RTimothyEdwards/gf180mcu_ocd_sram_test/doc/gf180mcu_ocd_sram_test.png

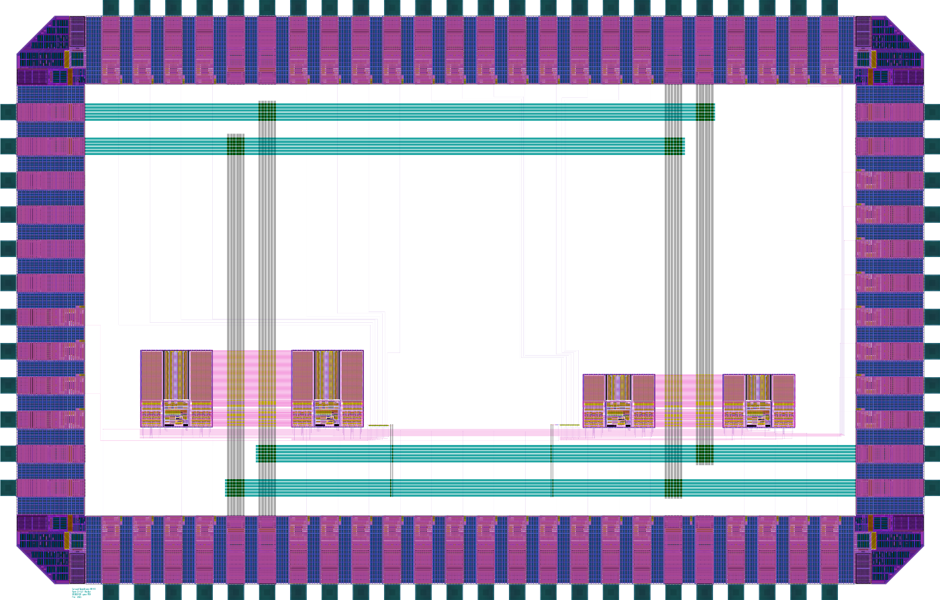
doc/gf180mcu_ocd_sram_test.png
