RTimothyEdwards/gf180mcu_ocd_sram_test/doc/chip_photo.jpg

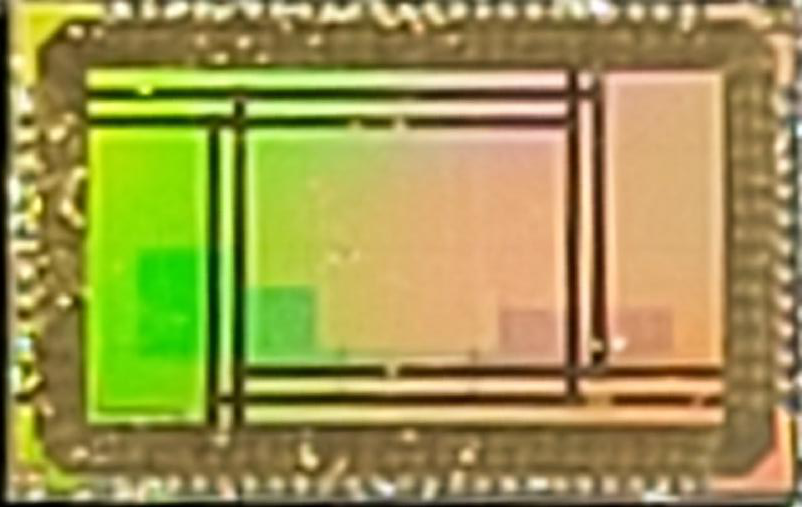
doc/chip_photo.jpg
