RTimothyEdwards/gf180mcu_ocd_sram_test/doc/README

3.3V SRAM and I/O test chip
------------------------
This chip uses a standard wafer.spice 1/2 size frame.
However, to test the 3.3V libraries, the following
changes are made:

(1) Pads are changed to the equivalent ocd_io pad library
    cells, except that the 24um drive pads are replaced
    with standard selectable drive pads.

(2) Every other pair of DVDD/DVSS pads are replaced with
    VDD/VSS pads (3.3V).

(3) The analog pads are not used

(4) The padframe uses a local loopback scheme to provide
    a fixed programming to each bidirectional pad to make
    it either input or output.

(5) Pad assignments are as follows, starting at the lower
    left hand corner and working counter-clockwise:

    Bottom row:
     1 (input only) CLK
     2 (input only) rst_n	(PoR enable)
     3 GWEN
     4 POR output (porb---low during reset)
     5 VSS
     6 VDD
     7 A7	(except for 64 byte SRAM)
     8 A6	(except for 64 byte SRAM)
     9 A5
    10 A4
    11 A3
    12 A2
    13 A1
    14 A0
    15 D7
    16 D6
    17 D5
    18 D4
    19 DVSS
    20 DVDD
    21 D3
    22 D2
    23 D1
    24 D0

   Right side
    25 VSS
    26 VDD
    27 CEN (1024 byte SRAM)
    28 CEN (512 byte SRAM)
    29 CEN (256 byte SRAM)
    30 CEN (64 byte SRAM)
    31 WEN7
    32 WEN6
    33 WEN5
    34 WEN4
    35 DVSS
    36 DVDD

   Top side
    37 WEN3
    38 WEN2
    39 WEN1
    40 WEN0
    41 VDD
    42 VSS
    43 Q7 (1024/512 byte)
    44 Q6 (1024/512 byte)
    45 Q5 (1024/512 byte)
    46 Q4 (1024/512 byte)
    47 Q3 (1024/512 byte)
    48 Q2 (1024/512 byte)
    49 Q1 (1024/512 byte)
    50 Q0 (1024/512 byte)
    51 Q7 (256/64 byte)
    52 Q6 (256/64 byte)
    53 Q5 (256/64 byte)
    54 Q4 (256/64 byte)
    55 DVDD
    56 DVSS
    57 Q3 (256/64 byte)
    58 Q2 (256/64 byte)
    59 Q1 (256/64 byte)
    60 Q0 (256/64 byte)

   Left side
    61 VDD
    62 VSS
    63 (analog, unused)
    64 (analog, unused)
    65 (analog, unused)
    66 (analog, unused)
    67 (input only) output select:  1024 byte or 512 byte
    68 (input only) A9 (1024 byte SRAM only)
    69 (input only) output select:  256 byte or 64 byte
    70 (input only) A8 (512 and 1024 byte SRAMs only)
    71 DVDD
    72 DVSS

----------------------------------------------------
Build procedure:
----------------------------------------------------

    cd magic
    ../scripts/run_gen_gds.sh
    ../scripts/run_fill_gds.sh

Copy the hash results from the last of the scripts into doc/hashes.txt

Run LVS and DRC:

    cd validate
    ./run_lvs.sh
    ./run_drc.sh

Run the complete precheck.  The precheck repository can be cloned and
is https://github.com/wafer-space/gf180mcu-precheck

    1. Start a nix-shell with the "shell.nix" file in the repository above.
	e.g.,

	cd ~/gits/gf180mcu-precheck
	nix-shell shell.nix

    2. Run the command:

	python3 precheck.py \
		--input ~/gits/gf180mcu_ocd_sram_test/gf180mcu_ocd_sram2_filled.gds.gz \
		--top gf180mcu_ocd_sram2_top \
		--slot 1x0p5 --cob \
		--workers max --threads 1

Push back to the repository once validated.

-----------------------------------------------------------------
Wafer.Space COB:

Using the breakout board found at:  https://codeberg.org/rebelmike/ws-breakout

This breakout board routes the 70-pin mezzanine connector to two 0.1" row
headers with 35 positions per row.

Mezzanine connector pin assignments

---------------------------------------------------------------------------------
test    pad	pad	     mezz.	mezz.	pad		pad	test
pin	num	name	      pin	pin	name		num	pin
---------------------------------------------------------------------------------
A3	11	bidir_6		70	1	bidir_5		10	A4
A2	12	bidir_7		69	2	bidir_4		9	A5
A1	13	bidir_8		68	3	bidir_3		8	A6
A0	14	bidir_9		67	4	bidir_2		7	A7
D7	15	bidir_10	66	5	bidir_1		4	POR out
D6	16	bidir_11	65	6	bidir_0		3	GWEN
D5	17	bidir_12	64	7	rst_n		2	rst_n
D4	18	bidir_13	63	8	clk		1	CLK
5.0V	20	VDD_IO_0	62	9	VDD_IO_3	71	5.0V
GND	  	GND		61	10	GND		  	GND
D3	21	bidir_14	60	11	VDD_CORE_1	6 	3.3V 
D2	22	bidir_15	59	12	in_3		70	A8
D1	23	bidir_16	58	13	in_2		69	SEL2
D0	24	bidir_17	57	14	in_1		68	A9
CEN1/5	27	bidir_18	56	15	in_0		67	SEL5
CEN2/5	28	bidir_19	55	16	an_3		66
3.3V	26  	PWR_AUX_0	54	17	an_2		65
GND	  	GND		53	18	GND		  	GND
CEN1/2	29	bidir_20	52	19	PWR_AUX_1	61	3.3V
CEN2/2	30	bidir_21	51	20	an_1		64
WEN0	31	bidir_22	50	21	an_0		63
WEN1	32	bidir_23	49	22	bidir_45	60	Q0/2
WEN2	33	bidir_24	48	23	bidir_44	59	Q1/2
WEN3	34	bidir_25	47	24	VDD_IO_2	55	5.0V  
3.3V	41  	VDD_CORE_0	46	25	GND		  	GND
GND	  	GND		45	26	bidir_43	58	Q2/2
5.0V	36  	VDD_IO_1	44	27	bidir_42	57	Q3/2
WEN4	37	bidir_26	43	28	bidir_41	54	Q4/2
WEN5	38	bidir_27	42	29	bidir_40	53	Q5/2
WEN6	39	bidir_28	41	30	bidir_39	52	Q6/2
WEN7	40	bidir_29	40	31	bidir_38	51	Q7/2
Q7/5	43	bidir_30	39	32	bidir_37	50	Q0/5
Q6/5	44	bidir_31	38	33	bidir_36	49	Q1/5
Q5/5	45	bidir_32	37	34	bidir_35	48	Q2/5
Q4/5	46	bidir_33	36	35	bidir_34	47	Q3/5

Test results below are for the original test chip manufactured on the first
Wafer.Space shuttle run, but the test setup below should be valid for both
versions of the SRAM test chip.

-----------------------------------------------------------------------------
Test with single Digilent Analog Discovery 2:
Exercise Lowest four data bits on D and Q, and lowest six address bits.
Start with the 256 byte side.

Assignments:
Digilent signal board pin
-------------------------
DIO 0	 clk	 8

DIO 1	 gwen	 6

DIO 2	 A0	67
DIO 3	 A1	68
DIO 4	 A2	69
DIO 5	 A3	70
DIO 6	 A4	 1
DIO 7	 A5	 2

DIO 8	 Q3/2	27
DIO 9	 Q2/2	26
DIO 10	 Q1/2	23
DIO 11	 Q0/2	22

DIO 12	 D3	60
DIO 13	 D2	59
DIO 14	 D1	58
DIO 15	 D0	57

All Q pins are for the 256 byte macros.
Data and address pins are shared by both sides.

Constant values:
GND	 D4	63
GND	 D5	64
GND	 D6	65
GND	 D7	66

GND	 A6	 3
GND	 A7	 4
GND	 A8	12
GND	 A9	14

GND	 WEN7	40
GND	 WEN6	41
GND	 WEN5	42
GND	 WEN4	43
GND	 WEN3	47
GND	 WEN2	48
GND	 WEN1	49
GND	 WEN0	50

open	 Q4/2	28
open	 Q5/2	29
open	 Q6/2	30
open	 Q7/2	31

GND	 SEL2	13	(select 256 byte bank 1 or 2 on Q/2 outputs)
GND	 SEL5	15	(select 512 or 1024 byte bank on Q/5 outputs))

GND	 CEN1/5	56	(enable all four for starters)
GND	 CEN2/5	55
GND	 CEN1/2	52
GND	 CEN2/2 51

Because the Digilent DIO channels only go to 3.3V, use 3.3V on the
periphery as well as the core (can also test the core at 1.8V).

Local WEN bits are set to zero;  GWEN controls the read/write state.

SEL lines:  GND selects bank 1, VDD selects bank 2

Functional note:  CEN must be high on power-on and then set to zero for
first use.

Writes must be done by setting GWEN low and applying a pulse on CLK, then
returning GWEN high.  The written value is not immediately available at
the output;  reading the output requires an additional pulse on CLK with
GWEN set high.

Additional testing to be done with two Digilent Analog Discovery units
(TBD).  The driver code for testing will be committed to the repository
when it is available.
