RTimothyEdwards/gf180mcu_ocd_sram_test/doc/4bit_count_bench_test.png

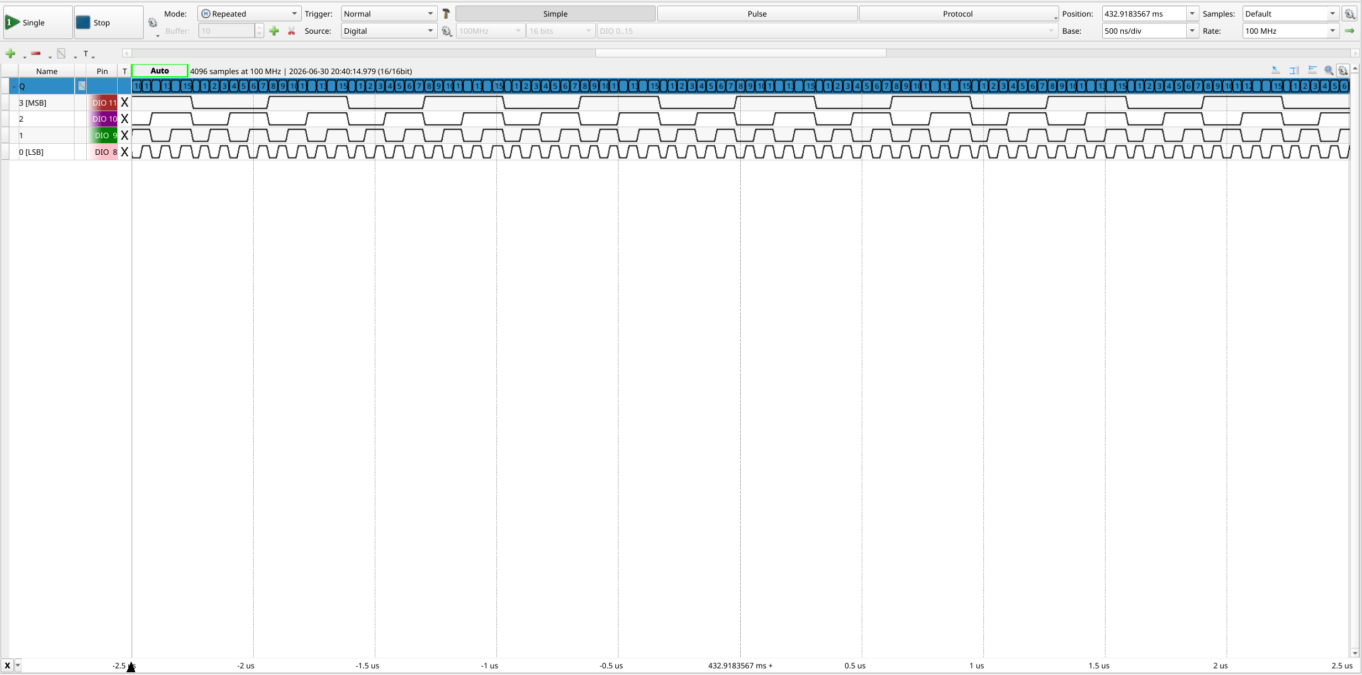
doc/4bit_count_bench_test.png
