RTimothyEdwards/gf180mcu_ocd_sram_test/ip/simple_por_3v3_regulated/netlist/layout/por_3v3_selfbiased.spice

* NGSPICE file created from por_3v3_selfbiased.ext - technology: gf180mcuD

.subckt nfet_03v3_UDCARV a_268_n100# a_364_n192# a_428_n100# a_n52_n100# a_524_n192#
+ a_n814_n286# a_n116_n192# a_588_n100# a_n212_n100# a_n276_n192# a_n372_n100# a_44_n192#
+ a_n436_n192# a_108_n100# a_204_n192# a_n532_n100# a_n676_n87# a_n596_n192#
X0 a_n52_n100# a_n116_n192# a_n212_n100# a_n814_n286# nfet_03v3 ad=0.26p pd=1.52u as=0.26p ps=1.52u w=1u l=0.28u
X1 a_588_n100# a_524_n192# a_428_n100# a_n814_n286# nfet_03v3 ad=0.43155p pd=2.88u as=0.26p ps=1.52u w=1u l=0.28u
X2 a_n212_n100# a_n276_n192# a_n372_n100# a_n814_n286# nfet_03v3 ad=0.26p pd=1.52u as=0.26p ps=1.52u w=1u l=0.28u
X3 a_108_n100# a_44_n192# a_n52_n100# a_n814_n286# nfet_03v3 ad=0.26p pd=1.52u as=0.26p ps=1.52u w=1u l=0.28u
X4 a_268_n100# a_204_n192# a_108_n100# a_n814_n286# nfet_03v3 ad=0.26p pd=1.52u as=0.26p ps=1.52u w=1u l=0.28u
X5 a_n372_n100# a_n436_n192# a_n532_n100# a_n814_n286# nfet_03v3 ad=0.26p pd=1.52u as=0.26p ps=1.52u w=1u l=0.28u
X6 a_428_n100# a_364_n192# a_268_n100# a_n814_n286# nfet_03v3 ad=0.26p pd=1.52u as=0.26p ps=1.52u w=1u l=0.28u
X7 a_n532_n100# a_n596_n192# a_n676_n87# a_n814_n286# nfet_03v3 ad=0.26p pd=1.52u as=0.43155p ps=2.88u w=1u l=0.28u
.ends

.subckt gf180mcu_as_sc_mcu7t3v3__buff_12 VDD VNW VPW VSS A Y
X0 VSS a_172_68# Y VPW nfet_03v3 ad=0.985p pd=3.97u as=0.26p ps=1.52u w=1u l=0.28u
X1 VSS a_172_68# Y VPW nfet_03v3 ad=0.26p pd=1.52u as=0.26p ps=1.52u w=1u l=0.28u
X2 VDD A a_172_68# VNW pfet_03v3 ad=0.3588p pd=1.9u as=0.3588p ps=1.9u w=1.38u l=0.28u
X3 Y a_172_68# VDD VNW pfet_03v3 ad=0.3588p pd=1.9u as=0.3588p ps=1.9u w=1.38u l=0.28u
X4 Y a_172_68# VDD VNW pfet_03v3 ad=0.3588p pd=1.9u as=0.3588p ps=1.9u w=1.38u l=0.28u
X5 VDD a_172_68# Y VNW pfet_03v3 ad=1.3593p pd=4.73u as=0.3588p ps=1.9u w=1.38u l=0.28u
X6 a_172_68# A VSS VPW nfet_03v3 ad=0.26p pd=1.52u as=0.44p ps=2.88u w=1u l=0.28u
X7 VSS a_172_68# Y VPW nfet_03v3 ad=0.26p pd=1.52u as=0.26p ps=1.52u w=1u l=0.28u
X8 VDD a_172_68# Y VNW pfet_03v3 ad=0.3588p pd=1.9u as=0.3588p ps=1.9u w=1.38u l=0.28u
X9 Y a_172_68# VDD VNW pfet_03v3 ad=0.36915p pd=1.915u as=0.3588p ps=1.9u w=1.38u l=0.28u
X10 VDD a_172_68# Y VNW pfet_03v3 ad=0.3588p pd=1.9u as=0.3588p ps=1.9u w=1.38u l=0.28u
X11 Y a_172_68# VSS VPW nfet_03v3 ad=0.26p pd=1.52u as=0.26p ps=1.52u w=1u l=0.28u
X12 Y a_172_68# VSS VPW nfet_03v3 ad=0.26p pd=1.52u as=0.26p ps=1.52u w=1u l=0.28u
X13 Y a_172_68# VDD VNW pfet_03v3 ad=0.3588p pd=1.9u as=0.3588p ps=1.9u w=1.38u l=0.28u
X14 Y a_172_68# VSS VPW nfet_03v3 ad=0.26p pd=1.52u as=0.26p ps=1.52u w=1u l=0.28u
X15 a_172_68# A VDD VNW pfet_03v3 ad=0.3588p pd=1.9u as=0.3588p ps=1.9u w=1.38u l=0.28u
X16 VSS a_172_68# Y VPW nfet_03v3 ad=0.26p pd=1.52u as=0.26p ps=1.52u w=1u l=0.28u
X17 VDD a_172_68# Y VNW pfet_03v3 ad=0.3588p pd=1.9u as=0.3588p ps=1.9u w=1.38u l=0.28u
X18 VSS A a_172_68# VPW nfet_03v3 ad=0.26p pd=1.52u as=0.26p ps=1.52u w=1u l=0.28u
X19 VSS a_172_68# Y VPW nfet_03v3 ad=0.26p pd=1.52u as=0.26p ps=1.52u w=1u l=0.28u
X20 VSS a_172_68# Y VPW nfet_03v3 ad=0.26p pd=1.52u as=0.2675p ps=1.535u w=1u l=0.28u
X21 VDD A a_172_68# VNW pfet_03v3 ad=0.3588p pd=1.9u as=0.3588p ps=1.9u w=1.38u l=0.28u
X22 Y a_172_68# VSS VPW nfet_03v3 ad=0.26p pd=1.52u as=0.26p ps=1.52u w=1u l=0.28u
X23 Y a_172_68# VDD VNW pfet_03v3 ad=0.3588p pd=1.9u as=0.3588p ps=1.9u w=1.38u l=0.28u
X24 a_172_68# A VSS VPW nfet_03v3 ad=0.26p pd=1.52u as=0.26p ps=1.52u w=1u l=0.28u
X25 Y a_172_68# VDD VNW pfet_03v3 ad=0.3588p pd=1.9u as=0.3588p ps=1.9u w=1.38u l=0.28u
X26 VDD a_172_68# Y VNW pfet_03v3 ad=0.3588p pd=1.9u as=0.3588p ps=1.9u w=1.38u l=0.28u
X27 Y a_172_68# VSS VPW nfet_03v3 ad=0.26p pd=1.52u as=0.26p ps=1.52u w=1u l=0.28u
X28 a_172_68# A VDD VNW pfet_03v3 ad=0.3588p pd=1.9u as=0.6072p ps=3.64u w=1.38u l=0.28u
X29 VDD a_172_68# Y VNW pfet_03v3 ad=0.3588p pd=1.9u as=0.36915p ps=1.915u w=1.38u l=0.28u
X30 VSS A a_172_68# VPW nfet_03v3 ad=0.26p pd=1.52u as=0.26p ps=1.52u w=1u l=0.28u
X31 Y a_172_68# VSS VPW nfet_03v3 ad=0.2675p pd=1.535u as=0.26p ps=1.52u w=1u l=0.28u
.ends

.subckt gf180mcu_as_sc_mcu7t3v3__inv_4 VDD VNW VPW VSS Y A
X0 VDD A Y VNW pfet_03v3 ad=0.3588p pd=1.9u as=0.3588p ps=1.9u w=1.38u l=0.28u
X1 Y A VSS VPW nfet_03v3 ad=0.26p pd=1.52u as=0.44p ps=2.88u w=1u l=0.28u
X2 Y A VDD VNW pfet_03v3 ad=0.3588p pd=1.9u as=0.3588p ps=1.9u w=1.38u l=0.28u
X3 VSS A Y VPW nfet_03v3 ad=0.52p pd=3.04u as=0.26p ps=1.52u w=1u l=0.28u
X4 VDD A Y VNW pfet_03v3 ad=0.7176p pd=3.8u as=0.3588p ps=1.9u w=1.38u l=0.28u
X5 Y A VSS VPW nfet_03v3 ad=0.26p pd=1.52u as=0.26p ps=1.52u w=1u l=0.28u
X6 Y A VDD VNW pfet_03v3 ad=0.3588p pd=1.9u as=0.6072p ps=3.64u w=1.38u l=0.28u
X7 VSS A Y VPW nfet_03v3 ad=0.26p pd=1.52u as=0.26p ps=1.52u w=1u l=0.28u
.ends

.subckt gf180mcu_as_sc_mcu7t3v3__fillcap_4 VDD VNW VPW VSS
X0 a_126_408# a_28_500# VSS VPW nfet_03v3 ad=0.44p pd=2.88u as=0.49p ps=2.98u w=1u l=1.03u
X1 VDD a_126_408# a_28_500# VNW pfet_03v3 ad=0.4752p pd=3.04u as=0.5292p ps=3.14u w=1.08u l=1.03u
.ends

.subckt ppolyf_u_1k_FPWM3N a_7600_n2622# a_5360_2500# a_2560_n2622# a_n13120_2500#
+ a_n12560_2500# a_n12840_n2622# a_3120_n2622# a_n5280_2500# a_8720_n2622# a_13200_2500#
+ a_n13400_n2622# a_12640_2500# a_12080_n2622# a_4800_2500# a_3680_n2622# a_n8080_n2622#
+ a_n13960_n2622# a_600_2500# a_4240_n2622# a_n4720_2500# a_9840_n2622# a_6200_2500#
+ a_13480_2500# a_5640_2500# a_n1640_n2622# a_n10040_n2622# a_n13400_2500# a_5360_n2622#
+ a_n12840_2500# a_n6120_2500# a_11800_n2622# a_880_2500# a_n2200_n2622# a_n5560_2500#
+ a_n240_2500# a_n7800_n2622# a_12920_2500# a_n240_n2622# a_n2760_n2622# a_n11160_n2622#
+ a_6480_n2622# a_7040_2500# a_6480_2500# a_12920_n2622# a_n3320_n2622# a_7040_n2622#
+ a_n8920_n2622# a_n13680_2500# a_n3880_n2622# a_n12280_n2622# a_13760_2500# a_5920_2500#
+ a_n4440_n2622# a_8160_n2622# a_n6400_2500# a_n5840_2500# a_n520_2500# a_n5000_n2622#
+ a_1160_2500# a_7320_2500# a_n5560_n2622# a_6760_2500# a_9280_n2622# a_320_n2622#
+ a_n1080_2500# a_10120_n2622# a_n13960_2500# a_1720_n2622# a_n6120_n2622# a_n7240_2500#
+ a_880_n2622# a_n1080_n2622# a_n6680_2500# a_10680_n2622# a_n6680_n2622# a_8160_2500#
+ a_11240_n2622# a_2840_n2622# a_n7240_n2622# a_2000_2500# a_n800_2500# a_3400_n2622#
+ a_1440_2500# a_n8080_2500# a_7600_2500# a_12360_n2622# a_n1360_2500# a_n8360_n2622#
+ a_3960_n2622# a_4520_n2622# a_n7520_2500# a_n6960_2500# a_13480_n2622# a_2280_2500#
+ a_n9480_n2622# a_n10040_2500# a_9000_2500# a_8440_2500# a_5640_n2622# a_n1920_n2622#
+ a_n10320_n2622# a_7880_2500# a_10120_2500# a_6200_n2622# a_1720_2500# a_n8360_2500#
+ a_n10880_n2622# a_n520_n2622# a_n2200_2500# a_1160_n2622# a_n1640_2500# a_n11440_n2622#
+ a_6760_n2622# a_9280_2500# a_n3600_n2622# a_n7800_2500# a_n12000_n2622# a_7320_n2622#
+ a_3120_2500# a_n10320_2500# a_2560_2500# a_2280_n2622# a_n12560_n2622# a_7880_n2622#
+ a_n3040_2500# a_8720_2500# a_n2480_2500# a_n4720_n2622# a_n13120_n2622# a_8440_n2622#
+ a_10400_2500# a_n9200_2500# a_n8640_2500# a_40_n2622# a_9000_n2622# a_n13680_n2622#
+ a_n1920_2500# a_n11160_2500# a_n5840_n2622# a_9560_n2622# a_9560_2500# a_10400_n2622#
+ a_600_n2622# a_11240_2500# a_n6400_n2622# a_10680_2500# a_3400_2500# a_n14172_n2834#
+ a_n9480_2500# a_n10600_2500# a_10960_n2622# a_2840_2500# a_n1360_n2622# a_5080_n2622#
+ a_n3320_2500# a_n6960_n2622# a_11520_n2622# a_n2760_2500# a_n7520_n2622# a_n8920_2500#
+ a_12080_2500# a_n2480_n2622# a_n12000_2500# a_4240_2500# a_3680_2500# a_n11440_2500#
+ a_12640_n2622# a_n3040_n2622# a_n10880_2500# a_n4160_2500# a_n8640_n2622# a_9840_2500#
+ a_11520_2500# a_13200_n2622# a_10960_2500# a_4800_n2622# a_n9200_n2622# a_n9760_2500#
+ a_n4160_n2622# a_5080_2500# a_13760_n2622# a_40_2500# a_n3600_2500# a_n9760_n2622#
+ a_n12280_2500# a_n10600_n2622# a_5920_n2622# a_12360_2500# a_n5280_n2622# a_4520_2500#
+ a_3960_2500# a_n5000_2500# a_n11720_2500# a_1440_n2622# a_320_2500# a_n800_n2622#
+ a_n4440_2500# a_n11720_n2622# a_n3880_2500# a_11800_2500# a_2000_n2622#
X0 a_9560_2500# a_9560_n2622# a_n14172_n2834# ppolyf_u_1k r_width=1u r_length=25u
X1 a_n3320_2500# a_n3320_n2622# a_n14172_n2834# ppolyf_u_1k r_width=1u r_length=25u
X2 a_n5840_2500# a_n5840_n2622# a_n14172_n2834# ppolyf_u_1k r_width=1u r_length=25u
X3 a_n10040_2500# a_n10040_n2622# a_n14172_n2834# ppolyf_u_1k r_width=1u r_length=25u
X4 a_n12560_2500# a_n12560_n2622# a_n14172_n2834# ppolyf_u_1k r_width=1u r_length=25u
X5 a_5080_2500# a_5080_n2622# a_n14172_n2834# ppolyf_u_1k r_width=1u r_length=25u
X6 a_2000_2500# a_2000_n2622# a_n14172_n2834# ppolyf_u_1k r_width=1u r_length=25u
X7 a_n1360_2500# a_n1360_n2622# a_n14172_n2834# ppolyf_u_1k r_width=1u r_length=25u
X8 a_4520_2500# a_4520_n2622# a_n14172_n2834# ppolyf_u_1k r_width=1u r_length=25u
X9 a_n3880_2500# a_n3880_n2622# a_n14172_n2834# ppolyf_u_1k r_width=1u r_length=25u
X10 a_12080_2500# a_12080_n2622# a_n14172_n2834# ppolyf_u_1k r_width=1u r_length=25u
X11 a_n9200_2500# a_n9200_n2622# a_n14172_n2834# ppolyf_u_1k r_width=1u r_length=25u
X12 a_n6120_2500# a_n6120_n2622# a_n14172_n2834# ppolyf_u_1k r_width=1u r_length=25u
X13 a_11520_2500# a_11520_n2622# a_n14172_n2834# ppolyf_u_1k r_width=1u r_length=25u
X14 a_n8640_2500# a_n8640_n2622# a_n14172_n2834# ppolyf_u_1k r_width=1u r_length=25u
X15 a_n10600_2500# a_n10600_n2622# a_n14172_n2834# ppolyf_u_1k r_width=1u r_length=25u
X16 a_2560_2500# a_2560_n2622# a_n14172_n2834# ppolyf_u_1k r_width=1u r_length=25u
X17 a_n4160_2500# a_n4160_n2622# a_n14172_n2834# ppolyf_u_1k r_width=1u r_length=25u
X18 a_7320_2500# a_7320_n2622# a_n14172_n2834# ppolyf_u_1k r_width=1u r_length=25u
X19 a_n6680_2500# a_n6680_n2622# a_n14172_n2834# ppolyf_u_1k r_width=1u r_length=25u
X20 a_9840_2500# a_9840_n2622# a_n14172_n2834# ppolyf_u_1k r_width=1u r_length=25u
X21 a_n13400_2500# a_n13400_n2622# a_n14172_n2834# ppolyf_u_1k r_width=1u r_length=25u
X22 a_n10320_2500# a_n10320_n2622# a_n14172_n2834# ppolyf_u_1k r_width=1u r_length=25u
X23 a_n2200_2500# a_n2200_n2622# a_n14172_n2834# ppolyf_u_1k r_width=1u r_length=25u
X24 a_n12840_2500# a_n12840_n2622# a_n14172_n2834# ppolyf_u_1k r_width=1u r_length=25u
X25 a_5360_2500# a_5360_n2622# a_n14172_n2834# ppolyf_u_1k r_width=1u r_length=25u
X26 a_n1640_2500# a_n1640_n2622# a_n14172_n2834# ppolyf_u_1k r_width=1u r_length=25u
X27 a_7880_2500# a_7880_n2622# a_n14172_n2834# ppolyf_u_1k r_width=1u r_length=25u
X28 a_4800_2500# a_4800_n2622# a_n14172_n2834# ppolyf_u_1k r_width=1u r_length=25u
X29 a_12360_2500# a_12360_n2622# a_n14172_n2834# ppolyf_u_1k r_width=1u r_length=25u
X30 a_n9480_2500# a_n9480_n2622# a_n14172_n2834# ppolyf_u_1k r_width=1u r_length=25u
X31 a_11800_2500# a_11800_n2622# a_n14172_n2834# ppolyf_u_1k r_width=1u r_length=25u
X32 a_n8920_2500# a_n8920_n2622# a_n14172_n2834# ppolyf_u_1k r_width=1u r_length=25u
X33 a_n10880_2500# a_n10880_n2622# a_n14172_n2834# ppolyf_u_1k r_width=1u r_length=25u
X34 a_n13120_2500# a_n13120_n2622# a_n14172_n2834# ppolyf_u_1k r_width=1u r_length=25u
X35 a_2840_2500# a_2840_n2622# a_n14172_n2834# ppolyf_u_1k r_width=1u r_length=25u
X36 a_8160_2500# a_8160_n2622# a_n14172_n2834# ppolyf_u_1k r_width=1u r_length=25u
X37 a_n4440_2500# a_n4440_n2622# a_n14172_n2834# ppolyf_u_1k r_width=1u r_length=25u
X38 a_7600_2500# a_7600_n2622# a_n14172_n2834# ppolyf_u_1k r_width=1u r_length=25u
X39 a_n6960_2500# a_n6960_n2622# a_n14172_n2834# ppolyf_u_1k r_width=1u r_length=25u
X40 a_320_2500# a_320_n2622# a_n14172_n2834# ppolyf_u_1k r_width=1u r_length=25u
X41 a_n11160_2500# a_n11160_n2622# a_n14172_n2834# ppolyf_u_1k r_width=1u r_length=25u
X42 a_n13680_2500# a_n13680_n2622# a_n14172_n2834# ppolyf_u_1k r_width=1u r_length=25u
X43 a_3120_2500# a_3120_n2622# a_n14172_n2834# ppolyf_u_1k r_width=1u r_length=25u
X44 a_n2480_2500# a_n2480_n2622# a_n14172_n2834# ppolyf_u_1k r_width=1u r_length=25u
X45 a_5640_2500# a_5640_n2622# a_n14172_n2834# ppolyf_u_1k r_width=1u r_length=25u
X46 a_n5000_2500# a_n5000_n2622# a_n14172_n2834# ppolyf_u_1k r_width=1u r_length=25u
X47 a_n1920_2500# a_n1920_n2622# a_n14172_n2834# ppolyf_u_1k r_width=1u r_length=25u
X48 a_10120_2500# a_10120_n2622# a_n14172_n2834# ppolyf_u_1k r_width=1u r_length=25u
X49 a_n7240_2500# a_n7240_n2622# a_n14172_n2834# ppolyf_u_1k r_width=1u r_length=25u
X50 a_880_2500# a_880_n2622# a_n14172_n2834# ppolyf_u_1k r_width=1u r_length=25u
X51 a_12640_2500# a_12640_n2622# a_n14172_n2834# ppolyf_u_1k r_width=1u r_length=25u
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
X99 a_n6400_2500# a_n6400_n2622# a_n14172_n2834# ppolyf_u_1k r_width=1u r_length=25u
.ends

.subckt diode_nd2ps_03v3_E3DKMC a_n181_n181# a_n45_n45#
D0 a_n181_n181# a_n45_n45# diode_nd2ps_03v3 pj=1.8u area=0.2025p
.ends

.subckt cap_mim_2p0fF_U8GDWG m4_9613_n4540# m4_n4567_n4660# m4_n10071_n4540# m4_n7379_n4660#
+ m4_3869_n4660# m4_6681_n4660# m4_3989_n4540# m4_12305_n4660# m4_9493_n4660# m4_12425_n4540#
+ m4_1057_n4660# m4_n13003_n4660# m4_1177_n4540# m4_n1635_n4540# m4_n4447_n4540# m4_n7259_n4540#
+ m4_n10191_n4660# m4_n12883_n4540# m4_6801_n4540# m4_n1755_n4660#
X0 m4_n1635_n4540# m4_n1755_n4660# cap_mim_2f0_m4m5_noshield c_width=10u c_length=10u
X1 m4_6801_n4540# m4_6681_n4660# cap_mim_2f0_m4m5_noshield c_width=10u c_length=10u
X2 m4_9613_n4540# m4_9493_n4660# cap_mim_2f0_m4m5_noshield c_width=10u c_length=10u
X3 m4_n7259_n4540# m4_n7379_n4660# cap_mim_2f0_m4m5_noshield c_width=10u c_length=10u
X4 m4_n12883_n4540# m4_n13003_n4660# cap_mim_2f0_m4m5_noshield c_width=10u c_length=10u
X5 m4_n12883_n4540# m4_n13003_n4660# cap_mim_2f0_m4m5_noshield c_width=10u c_length=10u
X6 m4_6801_n4540# m4_6681_n4660# cap_mim_2f0_m4m5_noshield c_width=10u c_length=10u
X7 m4_n1635_n4540# m4_n1755_n4660# cap_mim_2f0_m4m5_noshield c_width=10u c_length=10u
X8 m4_n4447_n4540# m4_n4567_n4660# cap_mim_2f0_m4m5_noshield c_width=10u c_length=10u
X9 m4_n1635_n4540# m4_n1755_n4660# cap_mim_2f0_m4m5_noshield c_width=10u c_length=10u
X10 m4_n1635_n4540# m4_n1755_n4660# cap_mim_2f0_m4m5_noshield c_width=10u c_length=10u
X11 m4_n12883_n4540# m4_n13003_n4660# cap_mim_2f0_m4m5_noshield c_width=10u c_length=10u
X12 m4_n4447_n4540# m4_n4567_n4660# cap_mim_2f0_m4m5_noshield c_width=10u c_length=10u
X13 m4_n4447_n4540# m4_n4567_n4660# cap_mim_2f0_m4m5_noshield c_width=10u c_length=10u
X14 m4_9613_n4540# m4_9493_n4660# cap_mim_2f0_m4m5_noshield c_width=10u c_length=10u
X15 m4_n10071_n4540# m4_n10191_n4660# cap_mim_2f0_m4m5_noshield c_width=10u c_length=10u
X16 m4_n10071_n4540# m4_n10191_n4660# cap_mim_2f0_m4m5_noshield c_width=10u c_length=10u
X17 m4_1177_n4540# m4_1057_n4660# cap_mim_2f0_m4m5_noshield c_width=10u c_length=10u
X18 m4_9613_n4540# m4_9493_n4660# cap_mim_2f0_m4m5_noshield c_width=10u c_length=10u
X19 m4_n7259_n4540# m4_n7379_n4660# cap_mim_2f0_m4m5_noshield c_width=10u c_length=10u
X20 m4_n7259_n4540# m4_n7379_n4660# cap_mim_2f0_m4m5_noshield c_width=10u c_length=10u
X21 m4_n7259_n4540# m4_n7379_n4660# cap_mim_2f0_m4m5_noshield c_width=10u c_length=10u
X22 m4_1177_n4540# m4_1057_n4660# cap_mim_2f0_m4m5_noshield c_width=10u c_length=10u
X23 m4_3989_n4540# m4_3869_n4660# cap_mim_2f0_m4m5_noshield c_width=10u c_length=10u
X24 m4_12425_n4540# m4_12305_n4660# cap_mim_2f0_m4m5_noshield c_width=10u c_length=10u
X25 m4_3989_n4540# m4_3869_n4660# cap_mim_2f0_m4m5_noshield c_width=10u c_length=10u
X26 m4_3989_n4540# m4_3869_n4660# cap_mim_2f0_m4m5_noshield c_width=10u c_length=10u
X27 m4_n4447_n4540# m4_n4567_n4660# cap_mim_2f0_m4m5_noshield c_width=10u c_length=10u
X28 m4_n10071_n4540# m4_n10191_n4660# cap_mim_2f0_m4m5_noshield c_width=10u c_length=10u
X29 m4_n12883_n4540# m4_n13003_n4660# cap_mim_2f0_m4m5_noshield c_width=10u c_length=10u
X30 m4_3989_n4540# m4_3869_n4660# cap_mim_2f0_m4m5_noshield c_width=10u c_length=10u
X31 m4_12425_n4540# m4_12305_n4660# cap_mim_2f0_m4m5_noshield c_width=10u c_length=10u
X32 m4_6801_n4540# m4_6681_n4660# cap_mim_2f0_m4m5_noshield c_width=10u c_length=10u
X33 m4_12425_n4540# m4_12305_n4660# cap_mim_2f0_m4m5_noshield c_width=10u c_length=10u
X34 m4_6801_n4540# m4_6681_n4660# cap_mim_2f0_m4m5_noshield c_width=10u c_length=10u
X35 m4_12425_n4540# m4_12305_n4660# cap_mim_2f0_m4m5_noshield c_width=10u c_length=10u
X36 m4_1177_n4540# m4_1057_n4660# cap_mim_2f0_m4m5_noshield c_width=10u c_length=10u
X37 m4_1177_n4540# m4_1057_n4660# cap_mim_2f0_m4m5_noshield c_width=10u c_length=10u
X38 m4_n10071_n4540# m4_n10191_n4660# cap_mim_2f0_m4m5_noshield c_width=10u c_length=10u
X39 m4_9613_n4540# m4_9493_n4660# cap_mim_2f0_m4m5_noshield c_width=10u c_length=10u
.ends

.subckt nfet_03v3_3DMKYT a_n334_n237# a_n52_n51# a_44_n143# a_n196_n39# a_108_n51#
+ a_n116_n143#
X0 a_n52_n51# a_n116_n143# a_n196_n39# a_n334_n237# nfet_03v3 ad=0.195p pd=1.27u as=0.3222p ps=2.38u w=0.75u l=0.28u
X1 a_108_n51# a_44_n143# a_n52_n51# a_n334_n237# nfet_03v3 ad=0.3222p pd=2.38u as=0.195p ps=1.27u w=0.75u l=0.28u
.ends

.subckt pfet_03v3_9U7ATZ a_n36_n143# w_n278_n261# a_28_n51# a_n116_n39#
X0 a_28_n51# a_n36_n143# a_n116_n39# w_n278_n261# pfet_03v3 ad=0.3222p pd=2.38u as=0.3222p ps=2.38u w=0.75u l=0.28u
.ends

.subckt pfet_03v3_VR43ZA a_n52_n51# a_44_n143# a_204_n143# a_n212_n51# w_n518_n261#
+ a_108_n51# a_268_n51# a_n116_n143# a_n356_n39# a_n276_n143#
X0 a_n52_n51# a_n116_n143# a_n212_n51# w_n518_n261# pfet_03v3 ad=0.195p pd=1.27u as=0.195p ps=1.27u w=0.75u l=0.28u
X1 a_n212_n51# a_n276_n143# a_n356_n39# w_n518_n261# pfet_03v3 ad=0.195p pd=1.27u as=0.3222p ps=2.38u w=0.75u l=0.28u
X2 a_108_n51# a_44_n143# a_n52_n51# w_n518_n261# pfet_03v3 ad=0.195p pd=1.27u as=0.195p ps=1.27u w=0.75u l=0.28u
X3 a_268_n51# a_204_n143# a_108_n51# w_n518_n261# pfet_03v3 ad=0.3222p pd=2.38u as=0.195p ps=1.27u w=0.75u l=0.28u
.ends

.subckt nfet_03v3_45Z7NE a_n144_n517# a_n56_n668# a_56_n576# a_n282_n762#
X0 a_56_n576# a_n56_n668# a_n144_n517# a_n282_n762# nfet_03v3 ad=2.60165p pd=12.88u as=2.60165p ps=12.88u w=6u l=0.56u
.ends

.subckt pfet_03v3_W2ZTV7 a_56_n276# a_n56_n368# w_n306_n486# a_n144_n247#
X0 a_56_n276# a_n56_n368# a_n144_n247# w_n306_n486# pfet_03v3 ad=1.30115p pd=6.88u as=1.30115p ps=6.88u w=3u l=0.56u
.ends

.subckt por_3v3_schmitt_inv vdd3v3 in out vss
XXM1 vss m1_2323_n1115# in vss vss in nfet_03v3_3DMKYT
XXM2 in vdd3v3 m1_2328_n243# out pfet_03v3_9U7ATZ
XXM3 vdd3v3 in in m1_2328_n243# vdd3v3 m1_2328_n243# vdd3v3 in vdd3v3 in pfet_03v3_VR43ZA
XXM5 m1_2323_n1115# out vdd3v3 vss nfet_03v3_45Z7NE
XXM6 m1_2328_n243# out vdd3v3 vss pfet_03v3_W2ZTV7
Xnfet_03v3_3DMKYT_0 vss out in m1_2323_n1115# m1_2323_n1115# in nfet_03v3_3DMKYT
.ends

.subckt pfet_03v3_KAPG2P a_444_n142# a_n36_n142# a_n836_n142# a_n452_n50# a_n932_n50#
+ a_604_n142# a_n196_n142# a_n1092_n50# a_n996_n142# a_348_n50# a_n1156_n142# a_828_n50#
+ a_988_n50# a_764_n142# a_n1236_n44# a_n356_n142# w_n1398_n266# a_124_n142# a_n132_n50#
+ a_924_n142# a_n292_n50# a_n612_n50# a_n772_n50# a_n516_n142# a_284_n142# a_508_n50#
+ a_188_n50# a_1084_n142# a_668_n50# a_n676_n142# a_1148_n50# a_28_n50#
X0 a_n292_n50# a_n356_n142# a_n452_n50# w_n1398_n266# pfet_03v3 ad=0.13p pd=1.02u as=0.13p ps=1.02u w=0.5u l=0.28u
X1 a_n772_n50# a_n836_n142# a_n932_n50# w_n1398_n266# pfet_03v3 ad=0.13p pd=1.02u as=0.13p ps=1.02u w=0.5u l=0.28u
X2 a_348_n50# a_284_n142# a_188_n50# w_n1398_n266# pfet_03v3 ad=0.13p pd=1.02u as=0.13p ps=1.02u w=0.5u l=0.28u
X3 a_828_n50# a_764_n142# a_668_n50# w_n1398_n266# pfet_03v3 ad=0.13p pd=1.02u as=0.13p ps=1.02u w=0.5u l=0.28u
X4 a_n932_n50# a_n996_n142# a_n1092_n50# w_n1398_n266# pfet_03v3 ad=0.13p pd=1.02u as=0.13p ps=1.02u w=0.5u l=0.28u
X5 a_28_n50# a_n36_n142# a_n132_n50# w_n1398_n266# pfet_03v3 ad=0.13p pd=1.02u as=0.13p ps=1.02u w=0.5u l=0.28u
X6 a_n452_n50# a_n516_n142# a_n612_n50# w_n1398_n266# pfet_03v3 ad=0.13p pd=1.02u as=0.13p ps=1.02u w=0.5u l=0.28u
X7 a_508_n50# a_444_n142# a_348_n50# w_n1398_n266# pfet_03v3 ad=0.13p pd=1.02u as=0.13p ps=1.02u w=0.5u l=0.28u
X8 a_988_n50# a_924_n142# a_828_n50# w_n1398_n266# pfet_03v3 ad=0.13p pd=1.02u as=0.13p ps=1.02u w=0.5u l=0.28u
X9 a_n1092_n50# a_n1156_n142# a_n1236_n44# w_n1398_n266# pfet_03v3 ad=0.13p pd=1.02u as=0.2161p ps=1.88u w=0.5u l=0.28u
X10 a_n612_n50# a_n676_n142# a_n772_n50# w_n1398_n266# pfet_03v3 ad=0.13p pd=1.02u as=0.13p ps=1.02u w=0.5u l=0.28u
X11 a_n132_n50# a_n196_n142# a_n292_n50# w_n1398_n266# pfet_03v3 ad=0.13p pd=1.02u as=0.13p ps=1.02u w=0.5u l=0.28u
X12 a_1148_n50# a_1084_n142# a_988_n50# w_n1398_n266# pfet_03v3 ad=0.2161p pd=1.88u as=0.13p ps=1.02u w=0.5u l=0.28u
X13 a_188_n50# a_124_n142# a_28_n50# w_n1398_n266# pfet_03v3 ad=0.13p pd=1.02u as=0.13p ps=1.02u w=0.5u l=0.28u
X14 a_668_n50# a_604_n142# a_508_n50# w_n1398_n266# pfet_03v3 ad=0.13p pd=1.02u as=0.13p ps=1.02u w=0.5u l=0.28u
.ends

.subckt pfet_03v3_HJ4KN5 a_444_n142# a_n36_n142# a_n836_n142# a_n452_n50# w_n1078_n266#
+ a_604_n142# a_n196_n142# a_348_n50# a_828_n50# a_764_n142# a_n356_n142# a_124_n142#
+ a_n132_n50# a_n292_n50# a_n612_n50# a_n772_n50# a_n516_n142# a_284_n142# a_508_n50#
+ a_188_n50# a_668_n50# a_n676_n142# a_28_n50# a_n916_n44#
X0 a_n292_n50# a_n356_n142# a_n452_n50# w_n1078_n266# pfet_03v3 ad=0.13p pd=1.02u as=0.13p ps=1.02u w=0.5u l=0.28u
X1 a_n772_n50# a_n836_n142# a_n916_n44# w_n1078_n266# pfet_03v3 ad=0.13p pd=1.02u as=0.2161p ps=1.88u w=0.5u l=0.28u
X2 a_348_n50# a_284_n142# a_188_n50# w_n1078_n266# pfet_03v3 ad=0.13p pd=1.02u as=0.13p ps=1.02u w=0.5u l=0.28u
X3 a_828_n50# a_764_n142# a_668_n50# w_n1078_n266# pfet_03v3 ad=0.2161p pd=1.88u as=0.13p ps=1.02u w=0.5u l=0.28u
X4 a_28_n50# a_n36_n142# a_n132_n50# w_n1078_n266# pfet_03v3 ad=0.13p pd=1.02u as=0.13p ps=1.02u w=0.5u l=0.28u
X5 a_n452_n50# a_n516_n142# a_n612_n50# w_n1078_n266# pfet_03v3 ad=0.13p pd=1.02u as=0.13p ps=1.02u w=0.5u l=0.28u
X6 a_508_n50# a_444_n142# a_348_n50# w_n1078_n266# pfet_03v3 ad=0.13p pd=1.02u as=0.13p ps=1.02u w=0.5u l=0.28u
X7 a_n612_n50# a_n676_n142# a_n772_n50# w_n1078_n266# pfet_03v3 ad=0.13p pd=1.02u as=0.13p ps=1.02u w=0.5u l=0.28u
X8 a_n132_n50# a_n196_n142# a_n292_n50# w_n1078_n266# pfet_03v3 ad=0.13p pd=1.02u as=0.13p ps=1.02u w=0.5u l=0.28u
X9 a_188_n50# a_124_n142# a_28_n50# w_n1078_n266# pfet_03v3 ad=0.13p pd=1.02u as=0.13p ps=1.02u w=0.5u l=0.28u
X10 a_668_n50# a_604_n142# a_508_n50# w_n1078_n266# pfet_03v3 ad=0.13p pd=1.02u as=0.13p ps=1.02u w=0.5u l=0.28u
.ends

.subckt pfet_03v3_C7VN8M a_268_n100# a_364_n192# a_428_n100# a_n676_n91# a_n52_n100#
+ a_524_n192# a_n116_n192# a_588_n100# a_n212_n100# a_n276_n192# a_n372_n100# a_44_n192#
+ a_n436_n192# w_n838_n310# a_108_n100# a_204_n192# a_n532_n100# a_n596_n192#
X0 a_n52_n100# a_n116_n192# a_n212_n100# w_n838_n310# pfet_03v3 ad=0.26p pd=1.52u as=0.26p ps=1.52u w=1u l=0.28u
X1 a_588_n100# a_524_n192# a_428_n100# w_n838_n310# pfet_03v3 ad=0.43415p pd=2.88u as=0.26p ps=1.52u w=1u l=0.28u
X2 a_n212_n100# a_n276_n192# a_n372_n100# w_n838_n310# pfet_03v3 ad=0.26p pd=1.52u as=0.26p ps=1.52u w=1u l=0.28u
X3 a_108_n100# a_44_n192# a_n52_n100# w_n838_n310# pfet_03v3 ad=0.26p pd=1.52u as=0.26p ps=1.52u w=1u l=0.28u
X4 a_268_n100# a_204_n192# a_108_n100# w_n838_n310# pfet_03v3 ad=0.26p pd=1.52u as=0.26p ps=1.52u w=1u l=0.28u
X5 a_n372_n100# a_n436_n192# a_n532_n100# w_n838_n310# pfet_03v3 ad=0.26p pd=1.52u as=0.26p ps=1.52u w=1u l=0.28u
X6 a_428_n100# a_364_n192# a_268_n100# w_n838_n310# pfet_03v3 ad=0.26p pd=1.52u as=0.26p ps=1.52u w=1u l=0.28u
X7 a_n532_n100# a_n596_n192# a_n676_n91# w_n838_n310# pfet_03v3 ad=0.26p pd=1.52u as=0.43415p ps=2.88u w=1u l=0.28u
.ends
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
