RTimothyEdwards/gf180mcu_ocd_sram_test/(commit log)

2025-12-07 Initial commit of 3.3V SRAM test chip for wafer.spice Run-1.
2025-12-09 Updated with some changes to the SRAM library to fix some contact positions, which eliminates some errors in the magic DRC checks. Made some other changes for LVS validation, most of which were label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
    [chip_half_frame.v, constant_block.v, ocd_mux_array.v]
2025-12-11 Updated to accommodate changes to the precheck and fill pattern generation from wafer.space. Also: Finished the verilog for the chip and completed LVS verification (albeit with the same ground short 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
    [chip_half_frame.v, gf180mcu_ocd_sram_test_tb.v, ocd_mux_array.v]
2025-12-11 Major update. Resolved issues with antenna violations in the klayout precheck by adding antenna tie-down diodes on each of the SRAM macro digital inputs (those that needed tie-downs). While doing tha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
2025-12-17 Updated the SRAM test after having spent the past two days creating schematics for the 1kB SRAM and validating LVS so that I know that the 1kB macro is good. Having done that, added the 1kB SRAM macr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
2025-12-18 Pushing an LVS clean version of the project. The changes needed for the clean LVS result did not involve any mask-level layout changes, so this push is being made on top of the version that was taped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
    [chip_half_frame.v]
2025-12-19 Changed the validation to do a full transistor-level comparison on all components (standard cells, SRAM macros, and I/O cells). Found an issue with the case of "VDD" and "VSS" in the SRAM macro repos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
2026-07-04 Updating from chip version 1 to chip version 2, to be taped out on the second Wafer.Space run. There is very little difference between the two chips---Both are intended as break-out test versions of 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
    [por_3v3_regulated.sch, por_3v3_schmitt_inv.sch, por_3v3_selfbiased.sch, por_amp.sch, schmitt_tb.sch, simple_por_tb.sch, simple_por_tb2.sch]
